kiu/RumbleRail/mech/readme.txt

Mechanical drawings (.fpd) are made with Frontplatten Designer
http://www.schaeffer-ag.de/de/download/frontplatten-designer.html
