kiu/RumbleRail/rrcmd/pcb/rrcmd.brd.png

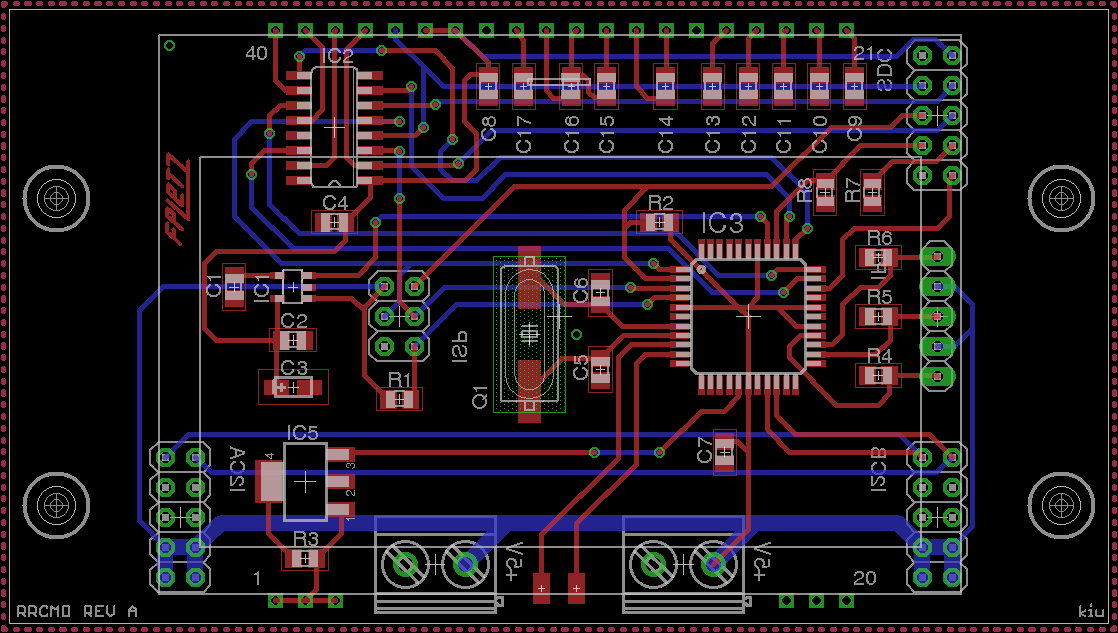
rrcmd/pcb/rrcmd.brd.png
