kiu/RumbleRail/rrcmd/pcb/rrcmd.sch.png

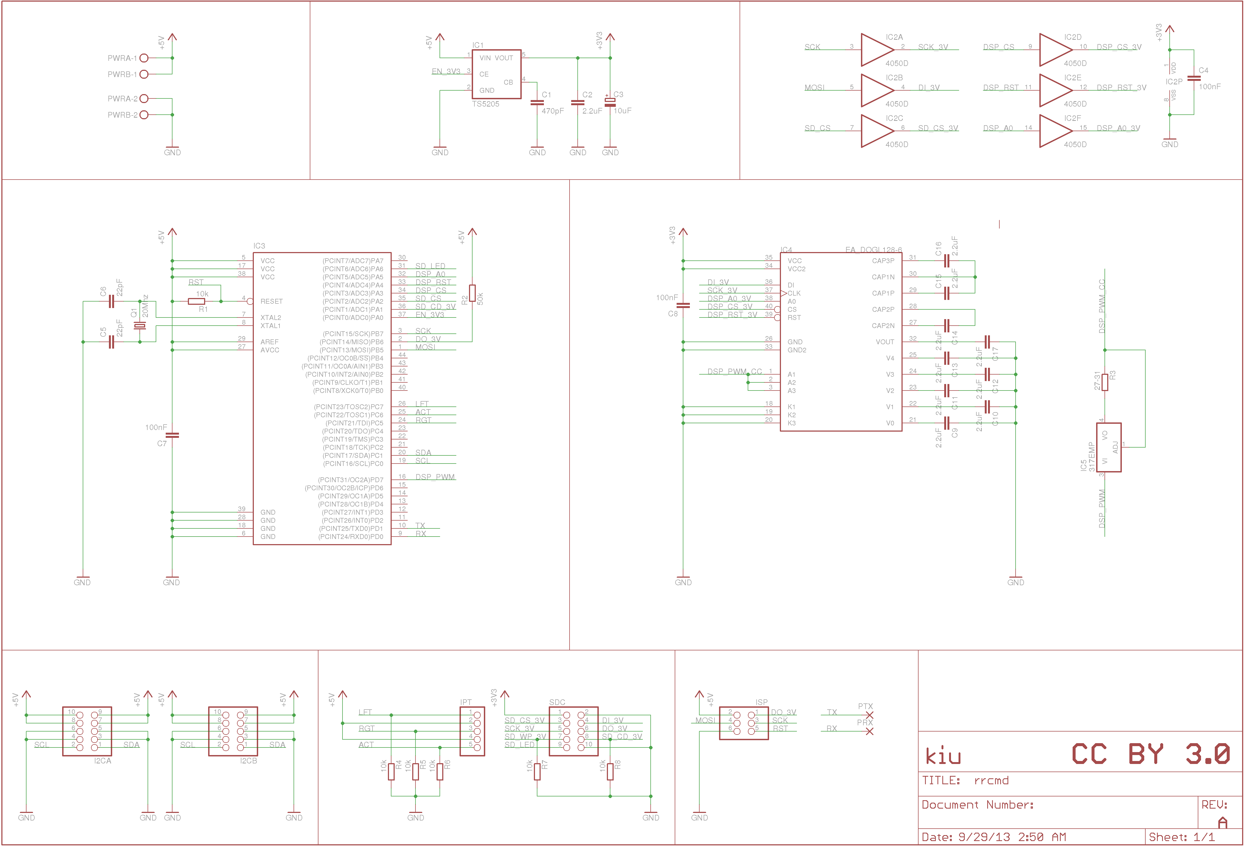
rrcmd/pcb/rrcmd.sch.png
