kiu/RumbleRail/rrfdc/pcb/rrfdc.brd.png

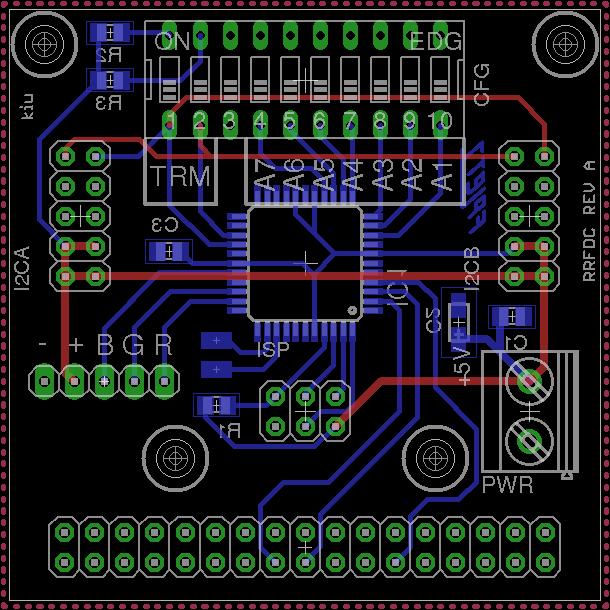
rrfdc/pcb/rrfdc.brd.png
