kiu/RumbleRail/rrfdc/pcb/rrfdc.sch.png

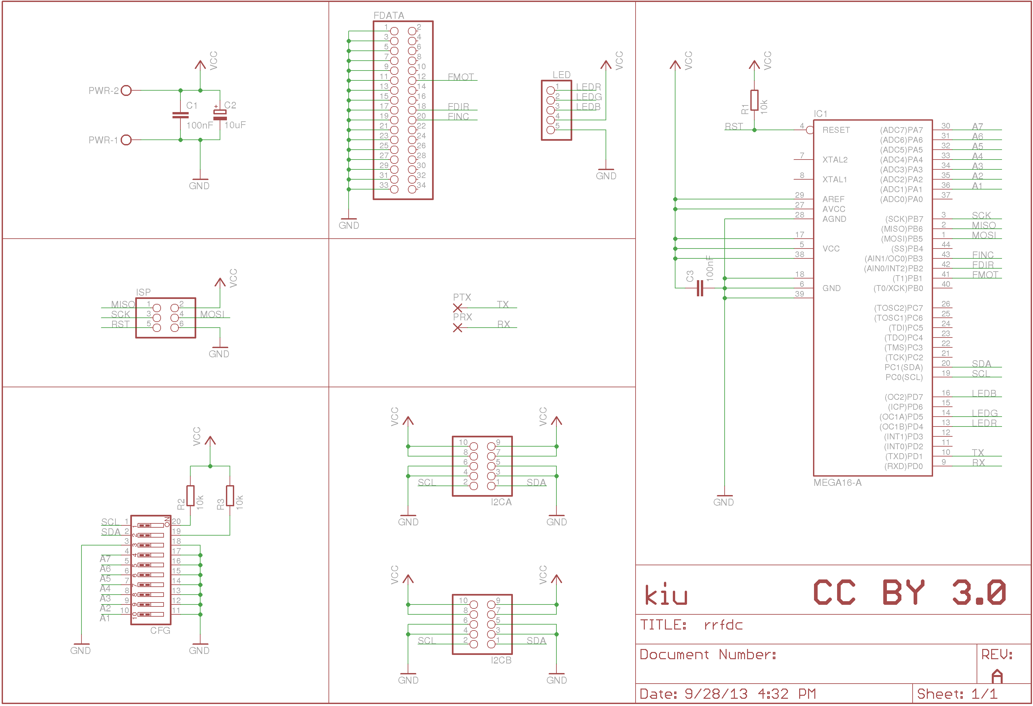
rrfdc/pcb/rrfdc.sch.png
