kiu/RumbleRail/rrled/pcb/rrled.brd.png

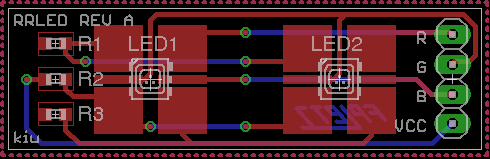
rrled/pcb/rrled.brd.png
