kiu/RumbleRail/rrled/pcb/rrled.sch.png

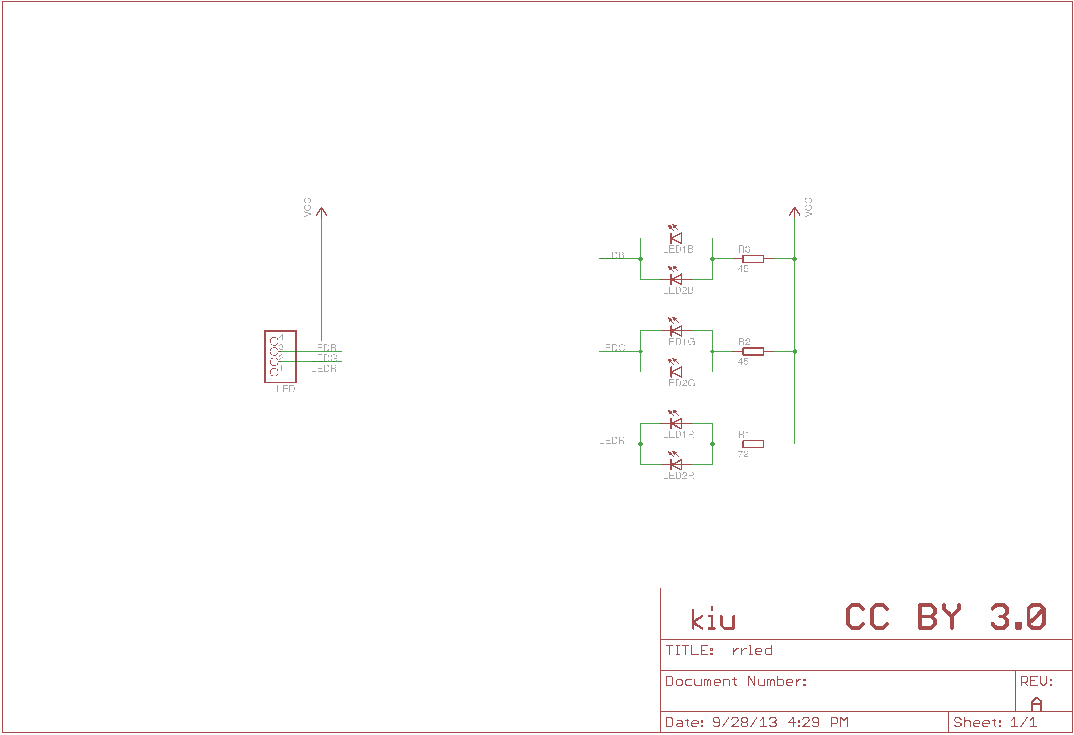
rrled/pcb/rrled.sch.png
