kiu/RumbleRail/rrsdc/pcb/rrsdc.brd.png

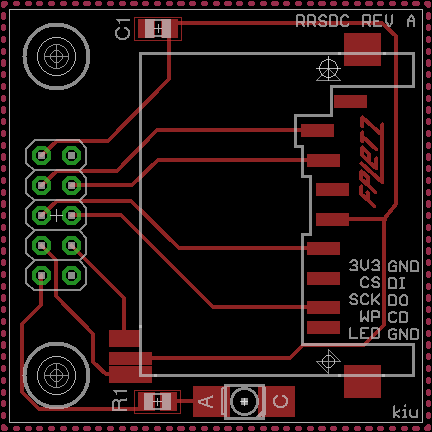
rrsdc/pcb/rrsdc.brd.png
