kiu/RumbleRail/rrsdc/pcb/rrsdc.sch.png

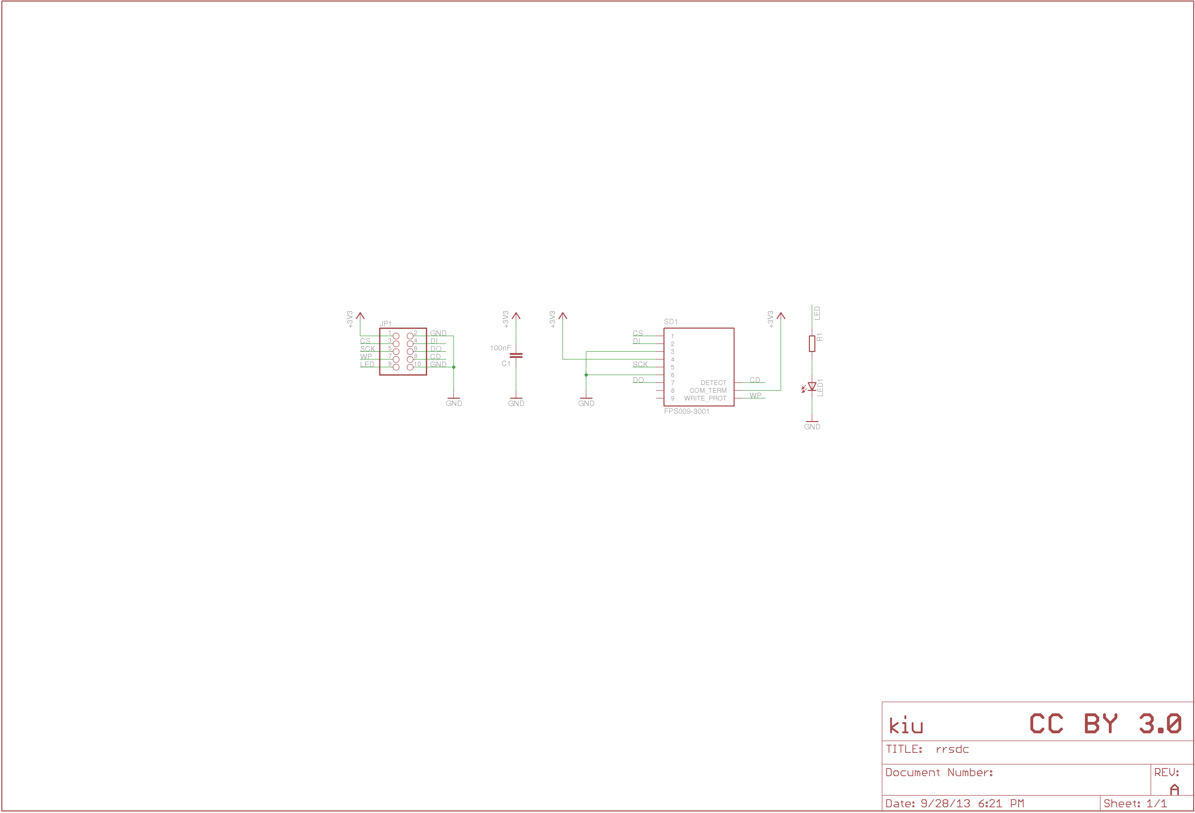
rrsdc/pcb/rrsdc.sch.png
