kiu/RumbleRail/bom.pdf

BOM

Ordered | Description | Qty | Price | Price (sum) | Id | Link

### 8x RRFDC

ATMEGA 16A-AU, TQFP-44 | 1 | 8 | 8 | 1.50 € | 12.00 € | ATMEGA 16A-AU
100nF 0805 | 2 | 8 | 100 | 0.01 € | 0.69 € | CC0805JRX7R9104
1 | 8 | 25 | 0.08 € | 1.99 € | TAJA106K006R
10k 0805 | 3 | 8 | 100 | 0.01 € | 0.83 € | SMD0805-10K-1%
DIP Switch 10 | 1 | 8 | 8 | 0.32 € | 2.56 € | NT 10
1 | 8 | 8 | 0.17 € | 1.36 € | WSL 34G
2 | 8 | 16 | 0.19 € | 3.04 € | PFL 34
1 | 1 | 1 | 3.20 € | 3.20 € | AWG 28-34G 3M
2 | 8 | 16 | 0.08 € | 1.28 € | WSL 10G
1 | 9 | 9 | 0.08 € | 0.72 € | PFL 10
1 | 1 | 1 | 3.00 € | 3.00 € | AWG 28-10F 3M
1 | 8 | 8 | 0.17 € | 1.36 € | WSL 6G
1 | 8 | 8 | 0.31 € | 2.48 € | AKL 101-02
1 | 8 | 8 | 0.57 € | 4.56 € | PS 25/5G BR
PCB 10x 50x50 Blue (RRFDC) | 0 | 0 | 0 | 0.00 € | 0.00 € | -
Screw M3x10 | 4 | 8 | 32 | 0.00 € | 0.00 € | -
4 | 8 | 32 | 0.04 € | 1.28 € | DK 5MM

### 8x RRLED

LED RGB | 2 | 8 | 16 | 0.99 € | 15.84 € | LRTB G6TG
45R (47) 0805 | 2 | 8 | 100 | 0.01 € | 0.83 € | SMD0805-47R-1%
72.5R (82) 0805 | 1 | 8 | 100 | 0.01 € | 0.83 € | SMD0805-82R-1%
PCB 10x 50x50 White (RRLED) | 0 | 0 | 0 | 0.00 € | 0.00 € | -

### 1x RRCMD

DOGL Display (128x64, Blue) | 1 | 1 | 1 | 21.10 € | 21.10 € | DOGL128B-6
1 | 1 | 1 | 16.85 € | 16.85 € | LED68X51-W
ATMEGA 1284P-AU | 1 | 1 | 1 | 5.90 € | 5.90 € | ATMEGA 1284P-AU
Crystal (20Mhz, HC49) | 1 | 1 | 1 | 0.24 € | 0.24 € | 20,0000-HC49-SMD
22pF | 2 | 1 | 2 | 0.05 € | 0.10 € | NPO-G0805 22P
LDO 3,3V 0.15A SOT235 | 1 | 1 | 1 | 0.29 € | 0.29 € | TS 5205 CX533
LM317 SOT-223 | 1 | 1 | 1 | 0.77 € | 0.77 € | LM 317 EMP
HC4050 | 1 | 1 | 1 | 0.26 € | 0.26 € | SMD HC 4050
470pF 0805 | 1 | 1 | 1 | 0.05 € | 0.05 € | NPO-G0805 470P
100nF 0805 | 3 | 1 | 100 | 0.01 € | 0.60 € | CC0805JRX7R9104
2.2uF 0805 | 10 | 1 | 100 | 0.02 € | 2.44 € | 0805YG225ZAT2A
1 | 1 | 25 | 0.08 € | 1.99 € | TAJA106K006R
10k 0805 | 6 | 1 | 100 | 0.01 € | 0.83 € | SMD0805-10K-1%
47k 0805 | 1 | 1 | 100 | 0.01 € | 0.83 € | SMD0805-47K-1%
33R (31.25) 0805 | 1 | 1 | 100 | 0.01 € | 0.83 € | SMD0805-33R-1%
1 | 1 | 1 | 0.57 € | 0.57 € | PS 25/5G BR
3 | 1 | 3 | 0.08 € | 0.24 € | WSL 10G
1 | 1 | 1 | 0.17 € | 0.17 € | WSL 6G
2 | 1 | 2 | 0.31 € | 0.62 € | AKL 101-02
1 | 1 | 1 | 3.95 € | 3.95 € | STEC11B09
Knopf | 1 | 1 | 1 | 3.30 € | 3.30 € | KNOPF 28-6 AL
1 | 1 | 1 | 0.22 € | 0.22 € | DECKEL 28M SW
PCB 5x 100x100 Red (RRCMD) | 0 | 0 | 0 | 0.00 € | 0.00 € | -
Screw M3x5 | 8 | 1 | 8 | 0.04 € | 0.29 € | B3X5/BN272

### 1x RRSDC

MMC/SD Holder | 1 | 1 | 1 | 0.81 € | 0.81 € | MCC-SD/1
100nF 0805 | 1 | 1 | 100 | 0.01 € | 0.60 € | CC0805JRX7R9104
1 | 1 | 1 | 0.08 € | 0.08 € | WSL 10G
2 | 1 | 2 | 0.08 € | 0.16 € | PFL 10
1 | 1 | 1 | 3.00 € | 3.00 € | AWG 28-10F 3M
PCB 5x 50x50 Red (RRSDC) | 0 | 0 | 0 | 0.00 € | 0.00 € | -
Screw M3x5 | 4 | 1 | 4 | 0.04 € | 0.14 € | B3X5/BN272
2 | 1 | 2 | 0.10 € | 0.20 € | TFF-M3X6/DR113

### Mechanical

Plate (Main) | 1 | 1 | 1 | 118.29 € | 118.29 € | -
Plate (Display) | 1 | 1 | 1 | 65.37 € | 65.37 € | -
Plate (Holder) | 1 | 1 | 1 | 31.40 € | 31.40 € | -
Shipping | 1 | 1 | 1 | 4.95 € | 4.95 € | -

### Misc

Power supply (5V, 8A) | 1 | 1 | 1 | 18.10 € | 18.10 € | SNT MW40-05
Power cord | 1 | 1 | 1 | 1.40 € | 1.40 € | NKS 200 SW
Power cable | 1 | 1 | 1 | 1.40 € | 1.40 € | LAT 275-5
SD Card 4GB | 1 | 1 | 1 | 3.80 € | 3.80 € | SAMSUNG MB-SS4GA
Floppy drives | 1 | 8 | 1 | 26.00 € | 26.00 € | -
0.5 | 8 | 4 | 1.59 € | 6.36 € | -
Shipping | 1 | 1 | 1 | 2.60 € | 2.60 € | -
Screw M3x5 | 8 | 8 | 64 | 0.04 € | 2.30 € | B3X5/BN272
4 | 8 | 32 | 0.10 € | 3.26 € | TFF-M3X6/DR113
Hex Bolt M5x50 | 4 | 1 | 4 | 0.00 € | 0.00 € | -
1 | 1 | 1 | 130.00 € | 130.00 € | (price may be incorrect!)
Shipping | 1 | 1 | 1 | 5.60 € | 5.60 € | -
Shipping | 1 | 1 | 1 | 5.90 € | 5.90 € | -

### SUM

552.03 € | (for 8 drives)
Req | Mul

http://www.reichelt.de
http://www.tme.eu
Tantal 10uF A | http://www.tme.eu
| http://www.tme.eu
| http://www.reichelt.de
Wannenstecker, 34-polig, gerade | http://www.reichelt.de
Pfostenbuchse (34pin) | http://www.reichelt.de
Ribboncable (34pin, 3m) | http://www.reichelt.de
Wannenstecker, 10-polig, gerade | http://www.reichelt.de
Pfostenbuchse (10pin) | http://www.reichelt.de
Ribboncable (10pin, 3m) | http://www.reichelt.de
Wannenstecker, 6-polig, gerade | http://www.reichelt.de
Anreihklemme 2pin, 5.08mm | http://www.reichelt.de
Platinensteckverbinder (5pin) | http://www.reichelt.de
| http://www.seeedstudio.com
Abstandshuelse M3x5 | http://www.reichelt.de

http://www.reichelt.de
http://www.tme.eu
http://www.tme.eu
http://www.seeedstudio.com

http://www.reichelt.de
DOGL Backlight (White) | http://www.reichelt.de
| http://www.reichelt.de
| http://www.reichelt.de
| http://www.reichelt.de
| http://www.reichelt.de
| http://www.reichelt.de
| http://www.reichelt.de
| http://www.reichelt.de
| http://www.tme.eu
| http://www.tme.eu
Tantal 10uF A | http://www.tme.eu
| http://www.tme.eu
| http://www.tme.eu
| http://www.tme.eu
Platinensteckverbinder (5pin) | http://www.reichelt.de
Wannenstecker, 10-polig, gerade | http://www.reichelt.de
Wannenstecker, 6-polig, gerade | http://www.reichelt.de
Anreihklemme 2pin, 5.08mm | http://www.reichelt.de
Drehimpulsgeber | http://www.reichelt.de
| http://www.reichelt.de
Deckel | http://www.reichelt.de
| http://www.seeedstudio.com
| http://www.tme.eu

http://www.tme.eu
http://www.tme.eu
Wannenstecker, 10-polig, gerade | http://www.reichelt.de
Pfostenbuchse (10pin) | http://www.reichelt.de
Ribboncable (10pin, 3m) | http://www.reichelt.de
| http://www.seeedstudio.com
| http://www.tme.eu
Abstandshuelse M3x6 | http://www.tme.eu

http://www.schaeffer-ag.dehttp://www.schaeffer-ag.dehttp://www.schaeffer-ag.dehttp://www.schaeffer-ag.de

http://www.reichelt.de
http://www.reichelt.de
http://www.reichelt.de

http://www.reichelt.de

http://www.ebay.de
Floppy Y Stromkabel | http://www.ebay.de
| http://www.ebay.de
| http://www.tme.eu
Abstandshuelse M3x6 | http://www.tme.eu
PCBs manufacturing, shipping, tax | http://www.seeedstudio.com
| http://www.reichelt.de http://www.tme.eu
A | B | C | D | E | F | G | H | I
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
