kiu/RumbleRail/bom.ods

Ordered | Description | Req | Mul | Qty | Price | Price (sum) | Id | Link
 | 8x RRFDC
 | ATMEGA 16A-AU, TQFP-44 | 1 | 8 | 8 | 1.50 € | 12.00 € | ATMEGA 16A-AU | http://www.reichelt.de
 | 100nF 0805 | 2 | 8 | 100 | 0.01 € | 0.69 € | CC0805JRX7R9104 | http://www.tme.eu
 | Tantal 10uF A | 1 | 8 | 25 | 0.08 € | 1.99 € | TAJA106K006R | http://www.tme.eu
 | 10k 0805 | 3 | 8 | 100 | 0.01 € | 0.83 € | SMD0805-10K-1% | http://www.tme.eu
 | DIP Switch 10 | 1 | 8 | 8 | 0.32 € | 2.56 € | NT 10 | http://www.reichelt.de
 | Wannenstecker, 34-polig, gerade | 1 | 8 | 8 | 0.17 € | 1.36 € | WSL 34G | http://www.reichelt.de
 | Pfostenbuchse (34pin) | 2 | 8 | 16 | 0.19 € | 3.04 € | PFL 34 | http://www.reichelt.de
 | Ribboncable (34pin, 3m) | 1 | 1 | 1 | 3.20 € | 3.20 € | AWG 28-34G 3M | http://www.reichelt.de
 | Wannenstecker, 10-polig, gerade | 2 | 8 | 16 | 0.08 € | 1.28 € | WSL 10G | http://www.reichelt.de
 | Pfostenbuchse (10pin) | 1 | 9 | 9 | 0.08 € | 0.72 € | PFL 10 | http://www.reichelt.de
 | Ribboncable (10pin, 3m) | 1 | 1 | 1 | 3.00 € | 3.00 € | AWG 28-10F 3M | http://www.reichelt.de
 | Wannenstecker, 6-polig, gerade | 1 | 8 | 8 | 0.17 € | 1.36 € | WSL 6G | http://www.reichelt.de
 | Anreihklemme 2pin, 5.08mm | 1 | 8 | 8 | 0.31 € | 2.48 € | AKL 101-02 | http://www.reichelt.de
 | Platinensteckverbinder (5pin) | 1 | 8 | 8 | 0.57 € | 4.56 € | PS 25/5G BR | http://www.reichelt.de
 | PCB 10x 50x50 Blue (RRFDC) | 0 | 0 | 0 | 0.00 € | 0.00 € | - | http://www.seeedstudio.com
 | Screw M3x10 | 4 | 8 | 32 | 0.00 € | 0.00 € | -
 | Abstandshuelse M3x5 | 4 | 8 | 32 | 0.04 € | 1.28 € | DK 5MM | http://www.reichelt.de
 | 8x RRLED
 | LED RGB | 2 | 8 | 16 | 0.99 € | 15.84 € | LRTB G6TG | http://www.reichelt.de
 | 45R (47) 0805 | 2 | 8 | 100 | 0.01 € | 0.83 € | SMD0805-47R-1% | http://www.tme.eu
 | 72.5R (82) 0805 | 1 | 8 | 100 | 0.01 € | 0.83 € | SMD0805-82R-1% | http://www.tme.eu
 | PCB 10x 50x50 White (RRLED) | 0 | 0 | 0 | 0.00 € | 0.00 € | - | http://www.seeedstudio.com
 | 1x RRCMD
 | DOGL Display (128x64, Blue) | 1 | 1 | 1 | 21.10 € | 21.10 € | DOGL128B-6 | http://www.reichelt.de
 | DOGL Backlight (White) | 1 | 1 | 1 | 16.85 € | 16.85 € | LED68X51-W | http://www.reichelt.de
 | ATMEGA 1284P-AU | 1 | 1 | 1 | 5.90 € | 5.90 € | ATMEGA 1284P-AU | http://www.reichelt.de
 | Crystal (20Mhz, HC49) | 1 | 1 | 1 | 0.24 € | 0.24 € | 20,0000-HC49-SMD | http://www.reichelt.de
 | 22pF | 2 | 1 | 2 | 0.05 € | 0.10 € | NPO-G0805 22P | http://www.reichelt.de
 | LDO 3,3V 0.15A SOT235 | 1 | 1 | 1 | 0.29 € | 0.29 € | TS 5205 CX533 | http://www.reichelt.de
 | LM317 SOT-223 | 1 | 1 | 1 | 0.77 € | 0.77 € | LM 317 EMP | http://www.reichelt.de
 | HC4050 | 1 | 1 | 1 | 0.26 € | 0.26 € | SMD HC 4050 | http://www.reichelt.de
 | 470pF 0805 | 1 | 1 | 1 | 0.05 € | 0.05 € | NPO-G0805 470P | http://www.reichelt.de
 | 100nF 0805 | 3 | 1 | 100 | 0.01 € | 0.60 € | CC0805JRX7R9104 | http://www.tme.eu
 | 2.2uF 0805 | 10 | 1 | 100 | 0.02 € | 2.44 € | 0805YG225ZAT2A | http://www.tme.eu
 | Tantal 10uF A | 1 | 1 | 25 | 0.08 € | 1.99 € | TAJA106K006R | http://www.tme.eu
 | 10k 0805 | 6 | 1 | 100 | 0.01 € | 0.83 € | SMD0805-10K-1% | http://www.tme.eu
 | 47k 0805 | 1 | 1 | 100 | 0.01 € | 0.83 € | SMD0805-47K-1% | http://www.tme.eu
 | 33R (31.25) 0805 | 1 | 1 | 100 | 0.01 € | 0.83 € | SMD0805-33R-1% | http://www.tme.eu
 | Platinensteckverbinder (5pin) | 1 | 1 | 1 | 0.57 € | 0.57 € | PS 25/5G BR | http://www.reichelt.de
 | Wannenstecker, 10-polig, gerade | 3 | 1 | 3 | 0.08 € | 0.24 € | WSL 10G | http://www.reichelt.de
 | Wannenstecker, 6-polig, gerade | 1 | 1 | 1 | 0.17 € | 0.17 € | WSL 6G | http://www.reichelt.de
 | Anreihklemme 2pin, 5.08mm | 2 | 1 | 2 | 0.31 € | 0.62 € | AKL 101-02 | http://www.reichelt.de
 | Drehimpulsgeber | 1 | 1 | 1 | 3.95 € | 3.95 € | STEC11B09 | http://www.reichelt.de
 | Knopf | 1 | 1 | 1 | 3.30 € | 3.30 € | KNOPF 28-6 AL | http://www.reichelt.de
 | Deckel | 1 | 1 | 1 | 0.22 € | 0.22 € | DECKEL 28M SW | http://www.reichelt.de
 | PCB 5x 100x100 Red (RRCMD) | 0 | 0 | 0 | 0.00 € | 0.00 € | - | http://www.seeedstudio.com
 | Screw M3x5 | 8 | 1 | 8 | 0.04 € | 0.29 € | B3X5/BN272 | http://www.tme.eu
 | 1x RRSDC
 | MMC/SD Holder | 1 | 1 | 1 | 0.81 € | 0.81 € | MCC-SD/1 | http://www.tme.eu
 | 100nF 0805 | 1 | 1 | 100 | 0.01 € | 0.60 € | CC0805JRX7R9104 | http://www.tme.eu
 | Wannenstecker, 10-polig, gerade | 1 | 1 | 1 | 0.08 € | 0.08 € | WSL 10G | http://www.reichelt.de
 | Pfostenbuchse (10pin) | 2 | 1 | 2 | 0.08 € | 0.16 € | PFL 10 | http://www.reichelt.de
 | Ribboncable (10pin, 3m) | 1 | 1 | 1 | 3.00 € | 3.00 € | AWG 28-10F 3M | http://www.reichelt.de
 | PCB 5x 50x50 Red (RRSDC) | 0 | 0 | 0 | 0.00 € | 0.00 € | - | http://www.seeedstudio.com
 | Screw M3x5 | 4 | 1 | 4 | 0.04 € | 0.14 € | B3X5/BN272 | http://www.tme.eu
 | Abstandshuelse M3x6 | 2 | 1 | 2 | 0.10 € | 0.20 € | TFF-M3X6/DR113 | http://www.tme.eu
 | Mechanical
 | Plate (Rail) | 1 | 1 | 1 | 118.29 € | 118.29 € | - | http://www.schaeffer-ag.de
 | Plate (Display) | 1 | 1 | 1 | 65.37 € | 65.37 € | - | http://www.schaeffer-ag.de
 | Plate (Mount) | 1 | 1 | 1 | 31.40 € | 31.40 € | - | http://www.schaeffer-ag.de
 | Shipping | 1 | 1 | 1 | 4.95 € | 4.95 € | - | http://www.schaeffer-ag.de
 | Misc
 | Power supply (5V, 8A) | 1 | 1 | 1 | 18.10 € | 18.10 € | SNT MW40-05 | http://www.reichelt.de
 | Power cord | 1 | 1 | 1 | 1.40 € | 1.40 € | NKS 200 SW | http://www.reichelt.de
 | Power cable | 1 | 1 | 1 | 1.40 € | 1.40 € | LAT 275-5 | http://www.reichelt.de
 | SD Card 4GB | 1 | 1 | 1 | 3.80 € | 3.80 € | SAMSUNG MB-SS4GA | http://www.reichelt.de
 | Floppy drives | 1 | 8 | 1 | 26.00 € | 26.00 € | - | http://www.ebay.de
 | Floppy Y Stromkabel | 0.5 | 8 | 4 | 1.59 € | 6.36 € | - | http://www.ebay.de
 | Shipping | 1 | 1 | 1 | 2.60 € | 2.60 € | - | http://www.ebay.de
 | Screw M3x5 | 8 | 8 | 64 | 0.04 € | 2.30 € | B3X5/BN272 | http://www.tme.eu
 | Abstandshuelse M3x6 | 4 | 8 | 32 | 0.10 € | 3.26 € | TFF-M3X6/DR113 | http://www.tme.eu
 | Hex Bolt M5x50 | 4 | 1 | 4 | 0.00 € | 0.00 € | -
 | PCBs manufacturing, shipping, tax | 1 | 1 | 1 | 130.00 € | 130.00 € | (price may be incorrect!) | http://www.seeedstudio.com
 | Shipping | 1 | 1 | 1 | 5.60 € | 5.60 € | - | http://www.reichelt.de
 | Shipping | 1 | 1 | 1 | 5.90 € | 5.90 € | - | http://www.tme.eu
 |  |  |  |  |  | SUM
 |  |  |  |  |  | 552.03 € | (for 8 drives)
