kiu/RumbleRail/mech/rr_rail.dxf

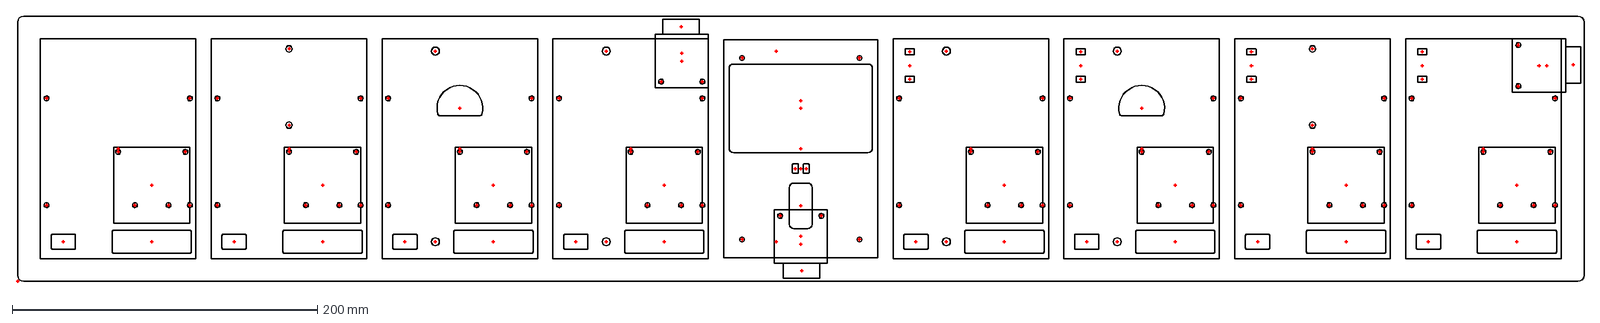
[picture p9: CAD file, 2014-01-03]
mech/rr_rail.dxf
1028.0 x 175.0 mm
