kiu/RumbleRail/mech/rr_rail_manu.dxf

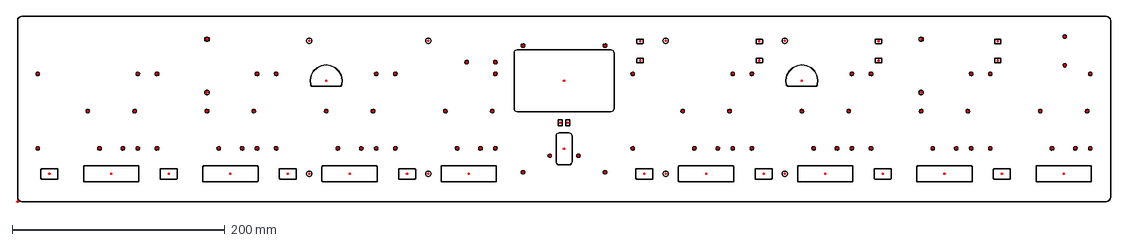
[picture p10: CAD file, 2014-01-03]
mech/rr_rail_manu.dxf
1028.0 x 175.0 mm
