kiu/RumbleRail/mech/rr_mount.dxf

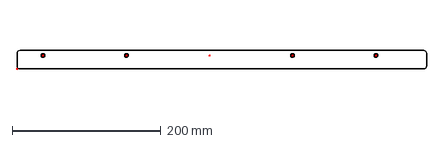
[picture p11: CAD file, 2014-01-03]
mech/rr_mount.dxf
551.0 x 26.0 mm
