kiu/RumbleRail/mech/rr_display.dxf

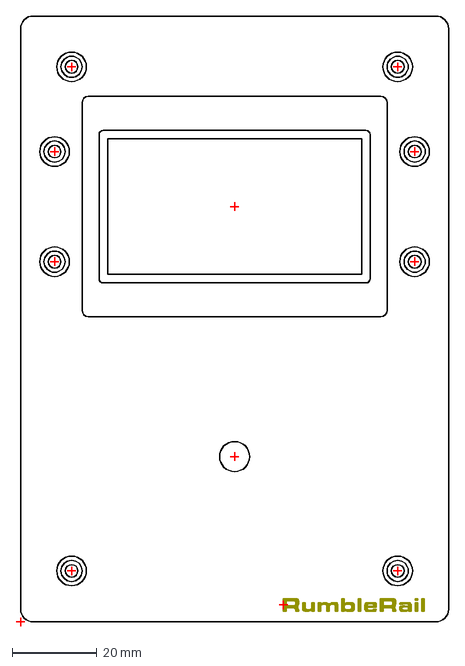
[picture p12: CAD file, 2014-01-03]
mech/rr_display.dxf
102.0 x 144.0 mm
