kiu/RumbleRail/mech/rr_display.pdf

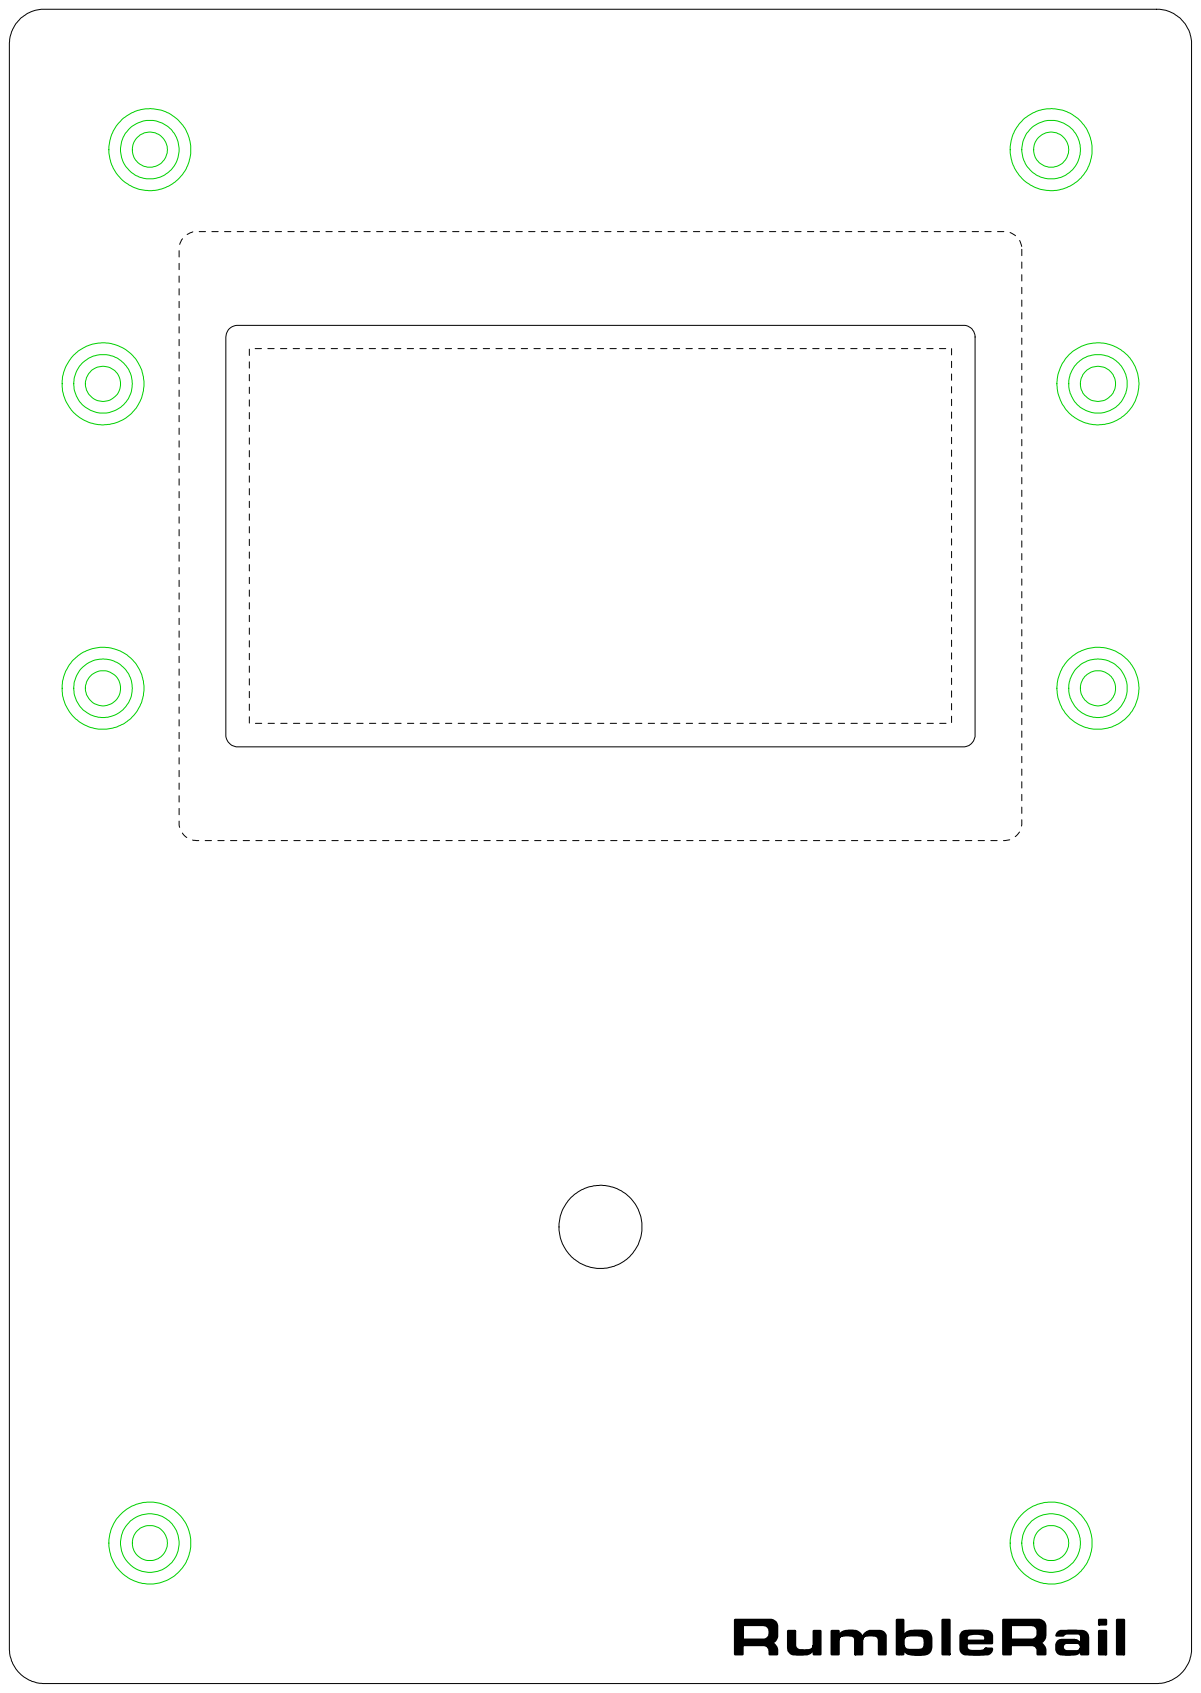
[picture p13: page 1]
