kiu/RumbleRail/mech/rr_rail.pdf

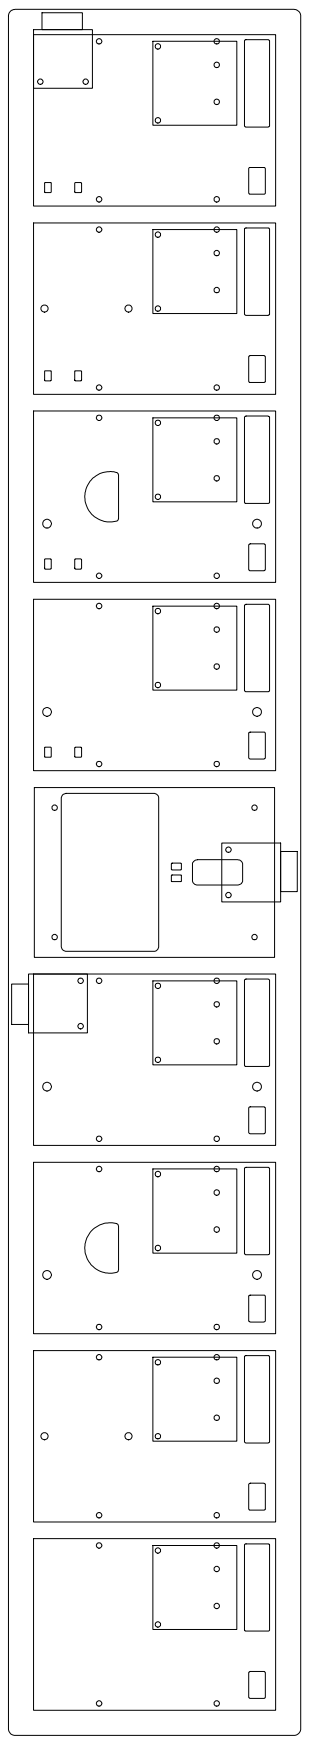
[picture p14: page 1]
