kiu/RumbleRail/mech/rr_rail_manu.pdf

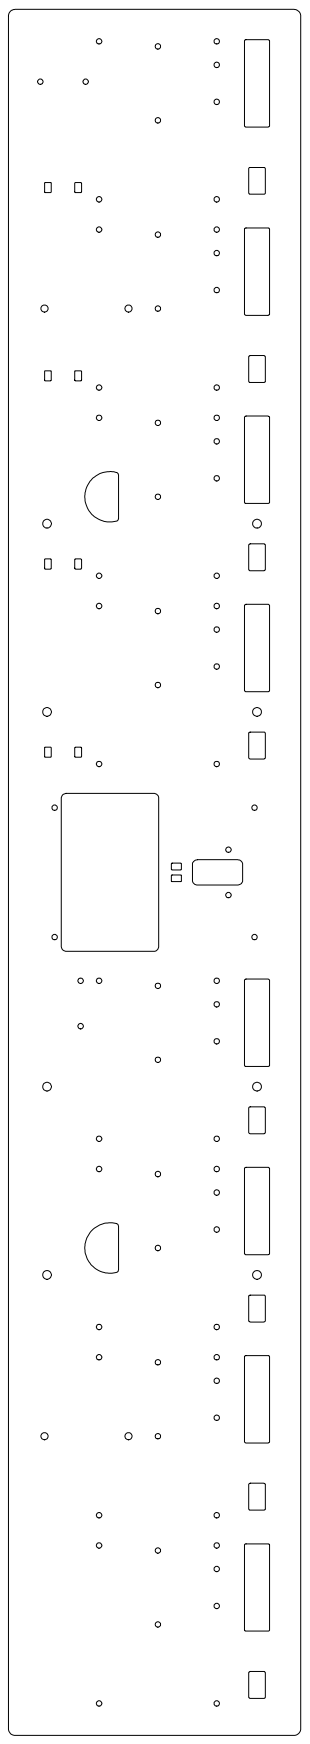
[picture p15: page 1]
