kiu/RumbleRail/rrcmd/pcb/rrcmd.brd

## EAGLE design rrcmd/pcb/rrcmd.brd (2014-01-03)

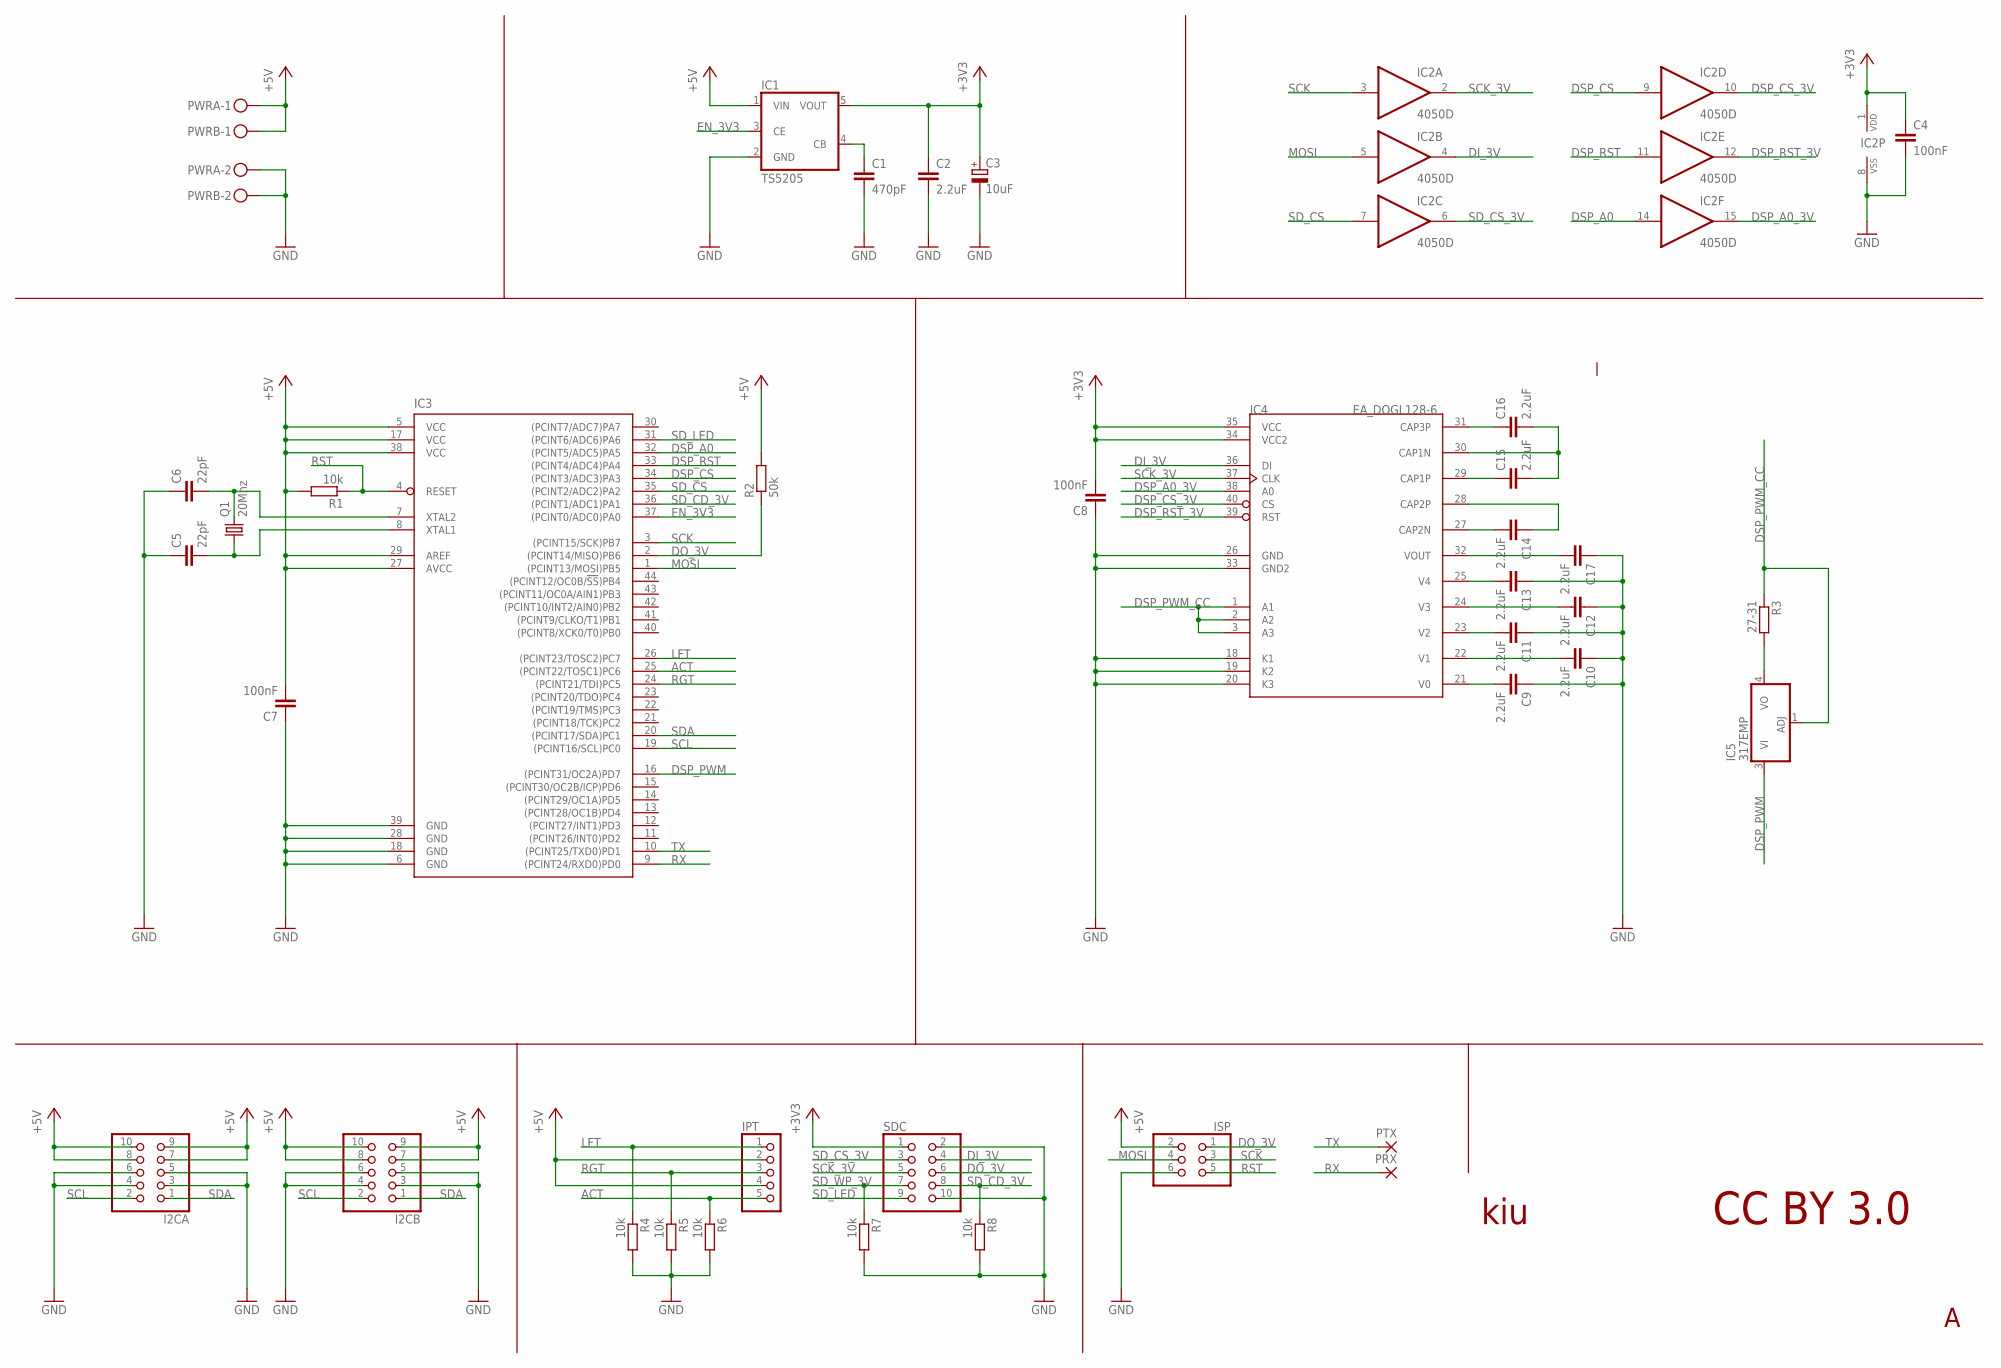
[picture p16: schematic rrcmd.sch]

Parts:
C1: 470pF; C0805
C2, C9, C10, C11, C12, C13, C14, C15, C16, C17: 2.2uF; C0805
C3: 10uF; CT3216
C4, C7, C8: 100nF; C0805
C5, C6: 22pF; C0805
I2CA, I2CB: PINHD-2X5; 2X05
IC1: TS5205; SOT25
IC2: 4050D; SO16
IC3: ATMEGA644A; TQFP44
IC4: EA_DOGL128-6
IC5: 317EMP; SOT223
IPT: PINHD-1X5; 1X05
ISP: PINHD-2X3; 2X03
PRX: SMD2; SMD1,27-2,54
PTX: SMD2; SMD1,27-2,54
PWRA: MKDSN1,5/2-5,08
PWRB: MKDSN1,5/2-5,08
Q1: 20Mhz; HC49UP
R1, R4, R5, R6, R7, R8: 10k; R0805
R2: 50k; R0805
R3: 27-31; R0805
SDC: PINHD-2X5; 2X05

Connections:
+3V3: C2.1, C3.+, C4.1, C8.2, IC1.5 (VOUT), IC2.1 (VDD), IC4.34 (VCC2), IC4.35 (VCC), SDC.1
+5V: C7.2, I2CA.7, I2CA.8, I2CA.9, I2CA.10, I2CB.7, I2CB.8, I2CB.9, I2CB.10, IC1.1 (VIN), IC3.5 (VCC), IC3.17 (VCC), IC3.27 (AVCC), IC3.29 (AREF), IC3.38 (VCC), IPT.2, IPT.4, ISP.2, PWRA.1, PWRB.1, R1.2, R2.2
ACT: IC3.25 ((PCINT22/TOSC1)PC6), IPT.5, R6.1
CAP1N: C15.2, C16.2, IC4.30 (CAP1N)
CAP1P: C15.1, IC4.29 (CAP1P)
CAP2N: C14.2, IC4.27 (CAP2N)
CAP2P: C14.1, IC4.28 (CAP2P)
CAP3P: C16.1, IC4.31 (CAP3P)
DI_3V: IC2.4 (O), IC4.36 (DI), SDC.4
DO_3V: IC3.2 ((PCINT14/MISO)PB6), ISP.1, R2.1, SDC.6
DSP_A0: IC2.14 (I), IC3.32 ((PCINT5/ADC5)PA5)
DSP_A0_3V: IC2.15 (O), IC4.38 (A0)
DSP_CS: IC2.9 (I), IC3.34 ((PCINT3/ADC3)PA3)
DSP_CS_3V: IC2.10 (O), IC4.40 (CS)
DSP_PWM: IC3.16 ((PCINT31/OC2A)PD7), IC5.3 (VI)
DSP_PWM_CC: IC4.1 (A1), IC4.2 (A2), IC4.3 (A3), IC5.1 (ADJ), R3.1
DSP_RST: IC2.11 (I), IC3.33 ((PCINT4/ADC4)PA4)
DSP_RST_3V: IC2.12 (O), IC4.39 (RST)
EN_3V3: IC1.3 (CE), IC3.37 ((PCINT0/ADC0)PA0)
GND: C1.2, C2.2, C3.-, C4.2, C5.1, C6.1, C7.1, C8.1, C9.1, C10.1, C11.1, C12.1, C13.1, C17.1, I2CA.3, I2CA.4, I2CA.5, I2CA.6, I2CB.3, I2CB.4, I2CB.5, I2CB.6, IC1.2 (GND), IC2.8 (VSS), IC3.6 (GND), IC3.18 (GND), IC3.28 (GND), IC3.39 (GND), IC4.18 (K1), IC4.19 (K2), IC4.20 (K3), IC4.26 (GND), IC4.33 (GND2), ISP.6, PWRA.2, PWRB.2, R4.2, R5.2, R6.2, R7.2, R8.2, SDC.2, SDC.10
LFT: IC3.26 ((PCINT23/TOSC2)PC7), IPT.1, R4.1
MOSI: IC2.5 (I), IC3.1 ((PCINT13/MOSI)PB5), ISP.4
unnamed: C1.1, IC1.4 (CB)
unnamed: C12.2, IC4.24 (V3)
unnamed: C13.2, IC4.25 (V4)
unnamed: C11.2, IC4.23 (V2)
unnamed: C10.2, IC4.22 (V1)
unnamed: C9.2, IC4.21 (V0)
unnamed: C17.2, IC4.32 (VOUT)
unnamed: IC5.4 (VO), R3.2
unnamed: C6.2, IC3.7 (XTAL2), Q1.2
unnamed: C5.2, IC3.8 (XTAL1), Q1.1
RGT: IC3.24 ((PCINT21/TDI)PC5), IPT.3, R5.1
RST: IC3.4 (RESET), ISP.5, R1.1
RX: IC3.9 ((PCINT24/RXD0)PD0), PRX.1
SCK: IC2.3 (I), IC3.3 ((PCINT15/SCK)PB7), ISP.3
SCK_3V: IC2.2 (O), IC4.37 (CLK), SDC.5
SCL: I2CA.2, I2CB.2, IC3.19 ((PCINT16/SCL)PC0)
SDA: I2CA.1, I2CB.1, IC3.20 ((PCINT17/SDA)PC1)
SD_CD_3V: IC3.36 ((PCINT1/ADC1)PA1), R8.1, SDC.8
SD_CS: IC2.7 (I), IC3.35 ((PCINT2/ADC2)PA2)
SD_CS_3V: IC2.6 (O), SDC.3
SD_LED: IC3.31 ((PCINT6/ADC6)PA6), SDC.9
SD_WP_3V: R7.1, SDC.7
TX: IC3.10 ((PCINT25/TXD0)PD1), PTX.1

Notes on the sheet:
CC BY 3.0
kiu

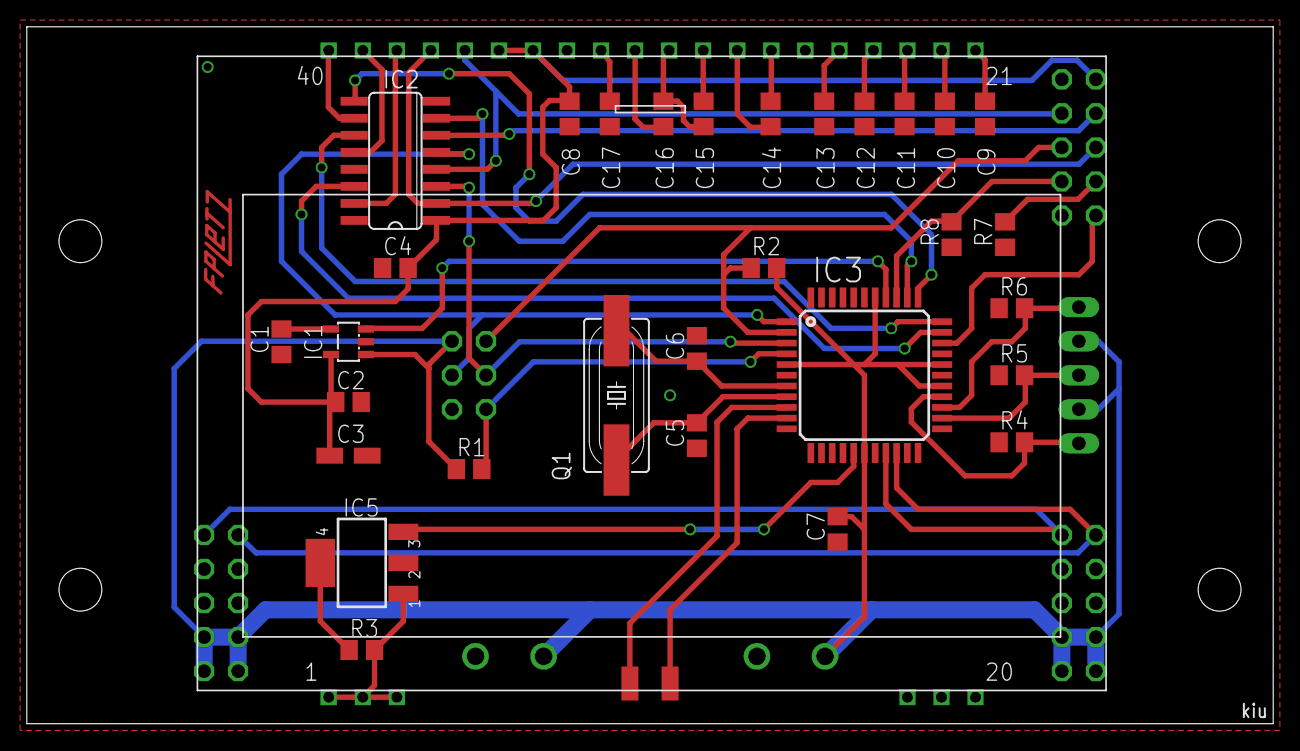
[picture p17: board rrcmd.brd from above]

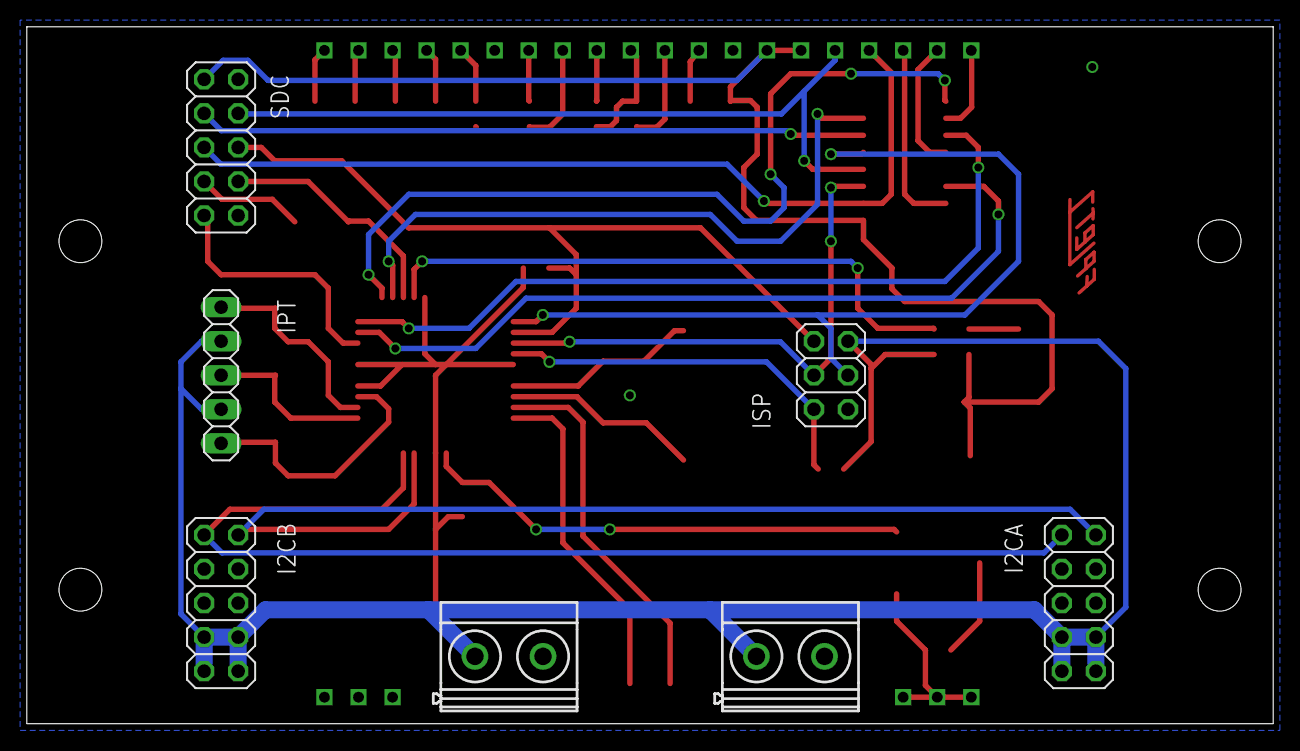
[picture p18: board rrcmd.brd from below]

Board: 4 copper layers, 93.0 x 52.0 mm, 40 parts (7 on the bottom side), 45 nets.
