kiu/RumbleRail/rrled/pcb/rrled.brd

## EAGLE design rrled/pcb/rrled.brd (2014-01-03)

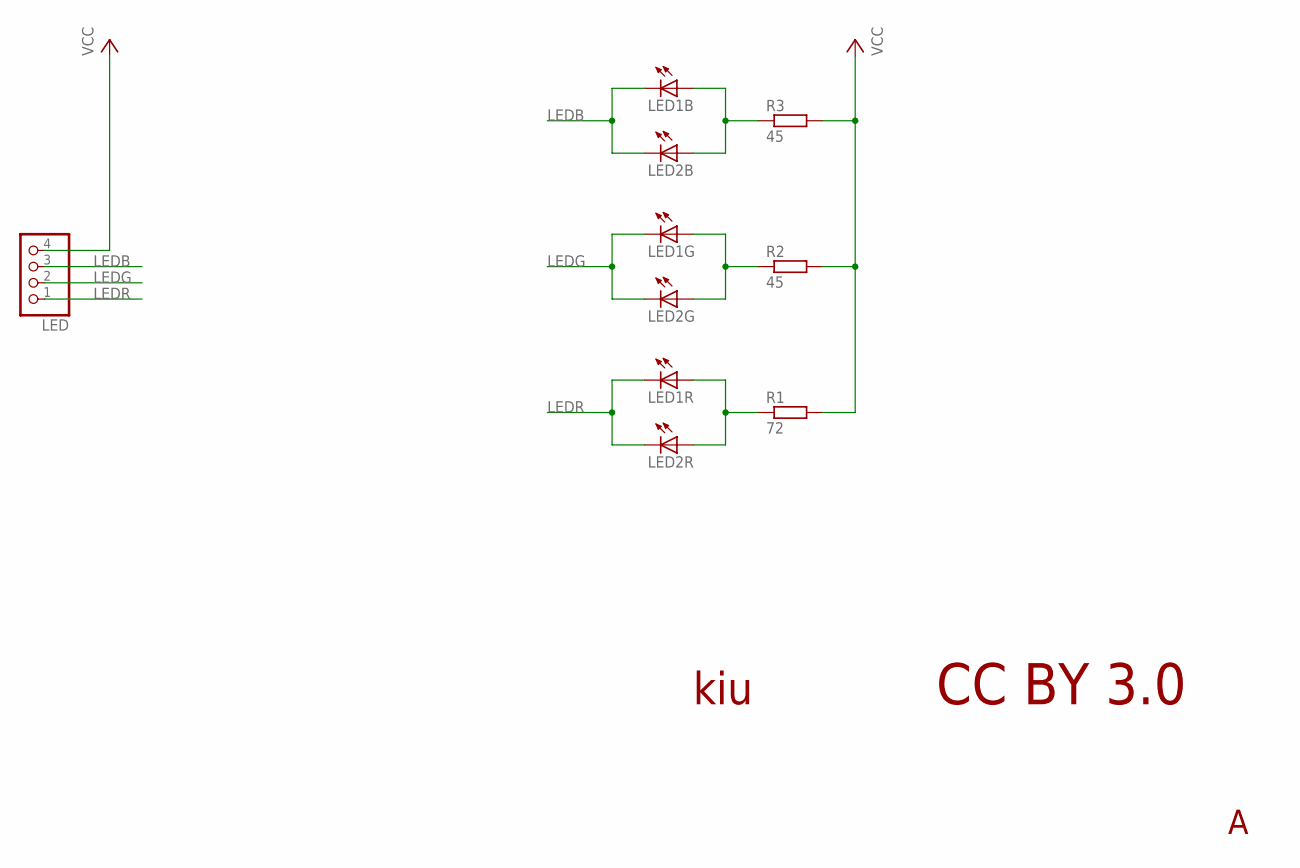
[picture p19: schematic rrled.sch]

Parts:
LED: PINHD-1X4; 1X04
LED1, LED2: MULTILED_LRTB_G6TG; P-LCC-6_TOPLED
R1: 72; R0603
R2, R3: 45; R0603

Connections:
LEDB: LED.3, LED1.C3 (C), LED2.C3 (C)
LEDG: LED.2, LED1.C2 (C), LED2.C2 (C)
LEDR: LED.1, LED1.C1 (C), LED2.C1 (C)
unnamed: LED1.A2 (A), LED2.A2 (A), R2.1
unnamed: LED1.A3 (A), LED2.A3 (A), R3.1
unnamed: LED1.A1 (A), LED2.A1 (A), R1.1
VCC: LED.4, R1.2, R2.2, R3.2

Notes on the sheet:
CC BY 3.0
kiu

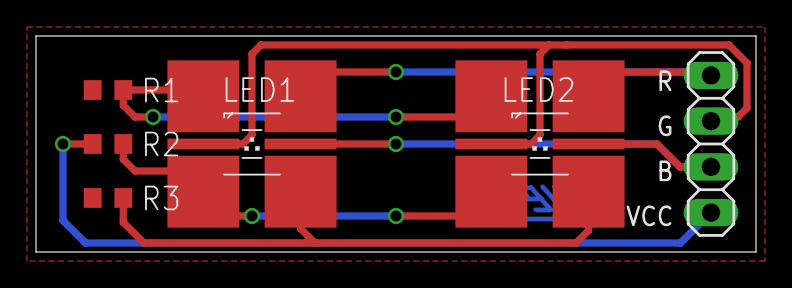
[picture p20: board rrled.brd from above]

Board: 4 copper layers, 40.0 x 12.0 mm, 6 parts (0 on the bottom side), 7 nets.
