kiu/RumbleRail/rrsdc/pcb/rrsdc.brd

## EAGLE design rrsdc/pcb/rrsdc.brd (2014-01-03)

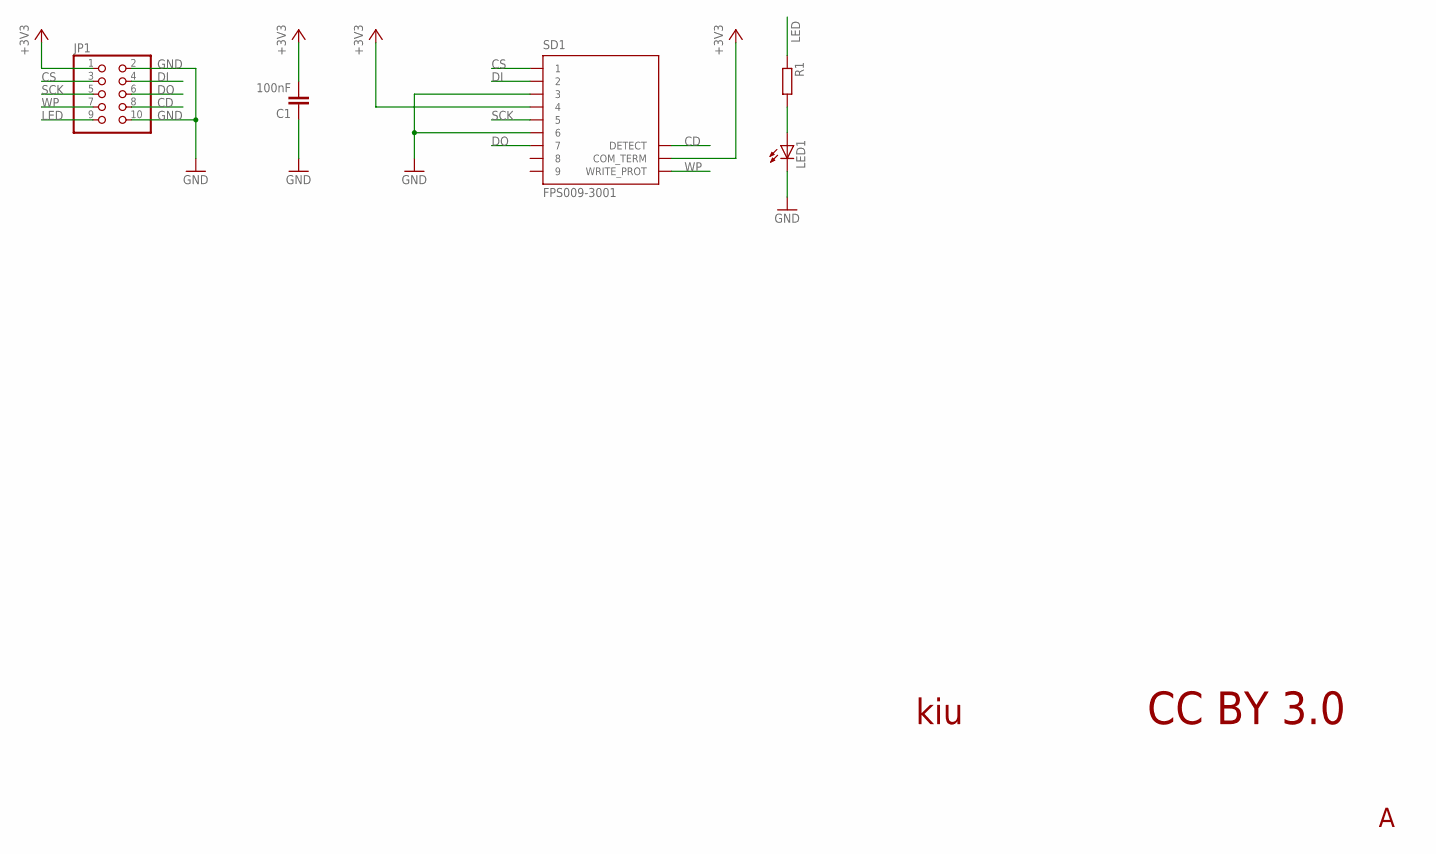
[picture p21: schematic rrsdc.sch]

Parts:
C1: 100nF; C0805
JP1: PINHD-2X5; 2X05
LED1: SIDELEDPLCC-NOTHERM; PLCC-2-NOTHERM
R1: R-EU_R0805; R0805
SD1: FPS009-3001; FPS009-3000

Connections:
+3V3: C1.2, JP1.1, SD1.4, SD1.COM_TERM
CD: JP1.8, SD1.DETECT
CS: JP1.3, SD1.1
DI: JP1.4, SD1.2
DO: JP1.6, SD1.7
GND: C1.1, JP1.2, JP1.10, LED1.C, SD1.3, SD1.6
LED: JP1.9, R1.1
unnamed: LED1.A, R1.2
SCK: JP1.5, SD1.5
WP: JP1.7, SD1.WRITE_PROT

Notes on the sheet:
CC BY 3.0
kiu

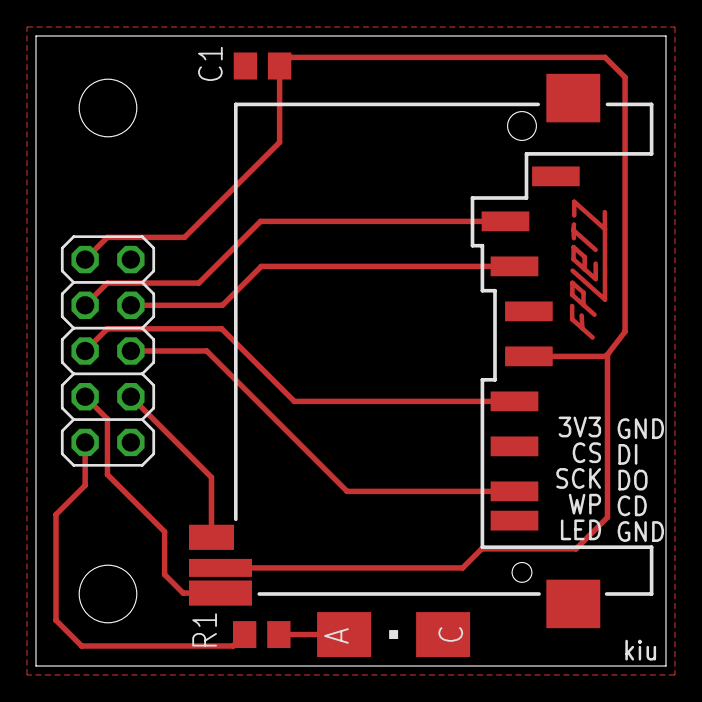
[picture p22: board rrsdc.brd from above]

Board: 4 copper layers, 35.0 x 35.0 mm, 5 parts (0 on the bottom side), 10 nets.
