kiu/RumbleRail/rrfdc/pcb/rrfdc.brd

## EAGLE design rrfdc/pcb/rrfdc.brd (2014-01-03)

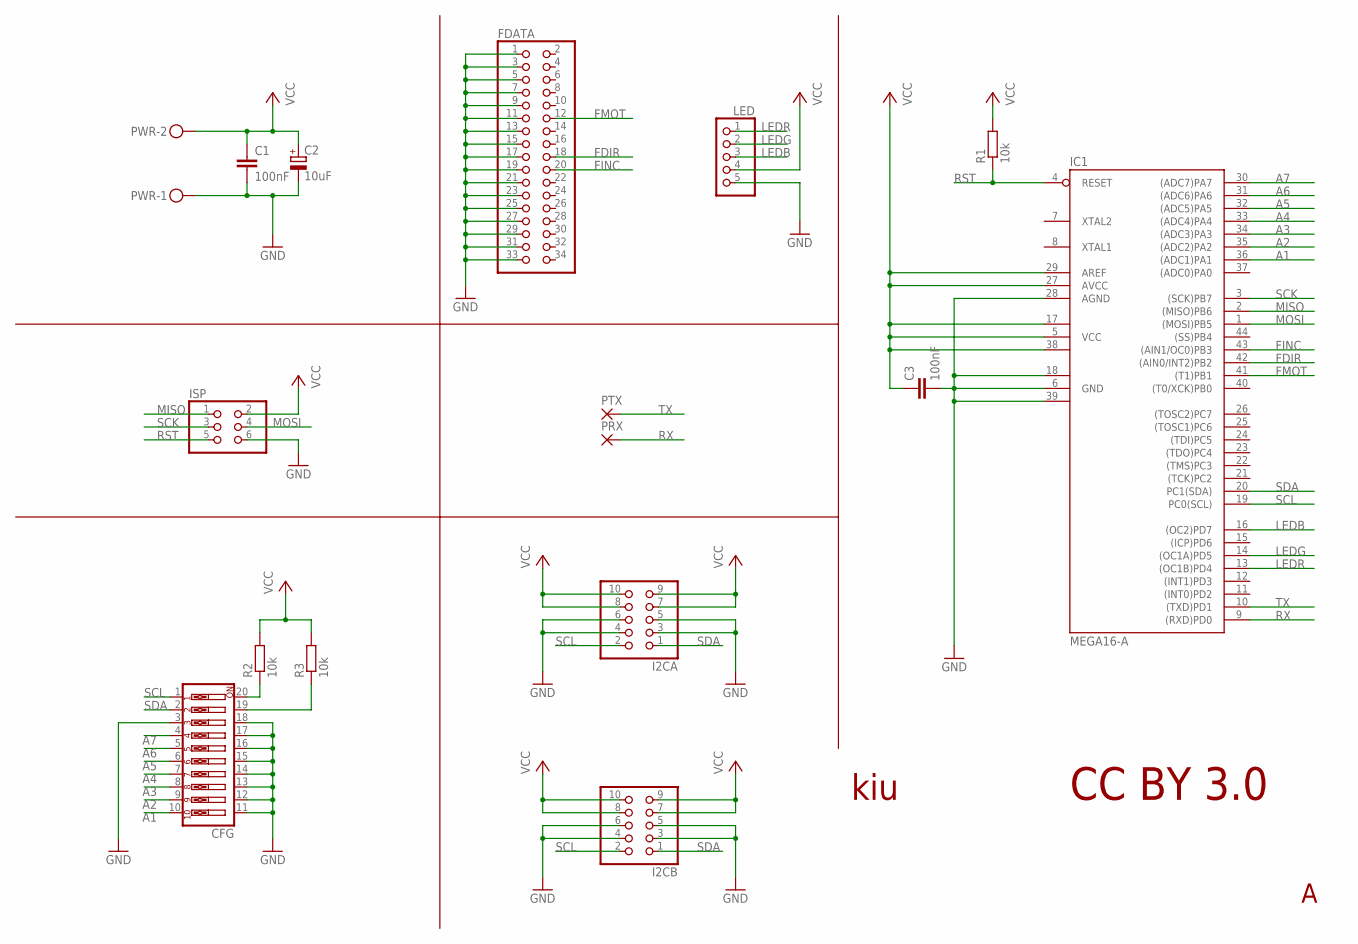
[picture p23: schematic rrfdc.sch]

Parts:
C1, C3: 100nF; C0805
C2: 10uF; CT3216
CFG: SW_DIP-10; EDG-10
FDATA: PINHD-2X17; 2X17
I2CA, I2CB: PINHD-2X5; 2X05
IC1: MEGA16-A; TQFP44
ISP: PINHD-2X3; 2X03
LED: PINHD-1X5; 1X05
PRX: SMD2; SMD1,27-2,54
PTX: SMD2; SMD1,27-2,54
PWR: MKDSN1,5/2-5,08
R1, R2, R3: 10k; R0805

Connections:
A1: CFG.10, IC1.36 ((ADC1)PA1)
A2: CFG.9, IC1.35 ((ADC2)PA2)
A3: CFG.8, IC1.34 ((ADC3)PA3)
A4: CFG.7, IC1.33 ((ADC4)PA4)
A5: CFG.6, IC1.32 ((ADC5)PA5)
A6: CFG.5, IC1.31 ((ADC6)PA6)
A7: CFG.4, IC1.30 ((ADC7)PA7)
FDIR: FDATA.18, IC1.42 ((AIN0/INT2)PB2)
FINC: FDATA.20, IC1.43 ((AIN1/OC0)PB3)
FMOT: FDATA.12, IC1.41 ((T1)PB1)
GND: C1.2, C2.-, C3.2, CFG.3, CFG.11, CFG.12, CFG.13, CFG.14, CFG.15, CFG.16, CFG.17, CFG.18, FDATA.1, FDATA.3, FDATA.5, FDATA.7, FDATA.9, FDATA.11, FDATA.13, FDATA.15, FDATA.17, FDATA.19, FDATA.21, FDATA.23, FDATA.25, FDATA.27, FDATA.29, FDATA.31, FDATA.33, I2CA.3, I2CA.4, I2CA.5, I2CA.6, I2CB.3, I2CB.4, I2CB.5, I2CB.6, IC1.6 (GND), IC1.18 (GND1), IC1.28 (AGND), IC1.39 (GND2), ISP.6, LED.5, PWR.1
LEDB: IC1.16 ((OC2)PD7), LED.3
LEDG: IC1.14 ((OC1A)PD5), LED.2
LEDR: IC1.13 ((OC1B)PD4), LED.1
MISO: IC1.2 ((MISO)PB6), ISP.1
MOSI: IC1.1 ((MOSI)PB5), ISP.4
unnamed: CFG.20, R2.1
unnamed: CFG.19, R3.1
RST: IC1.4 (RESET), ISP.5, R1.1
RX: IC1.9 ((RXD)PD0), PRX.1
SCK: IC1.3 ((SCK)PB7), ISP.3
SCL: CFG.1, I2CA.2, I2CB.2, IC1.19 (PC0(SCL))
SDA: CFG.2, I2CA.1, I2CB.1, IC1.20 (PC1(SDA))
TX: IC1.10 ((TXD)PD1), PTX.1
VCC: C1.1, C2.+, C3.1, I2CA.7, I2CA.8, I2CA.9, I2CA.10, I2CB.7, I2CB.8, I2CB.9, I2CB.10, IC1.5 (VCC), IC1.17 (VCC1), IC1.27 (AVCC), IC1.29 (AREF), IC1.38 (VCC2), ISP.2, LED.4, PWR.2, R1.2, R2.2, R3.2

Notes on the sheet:
CC BY 3.0
kiu

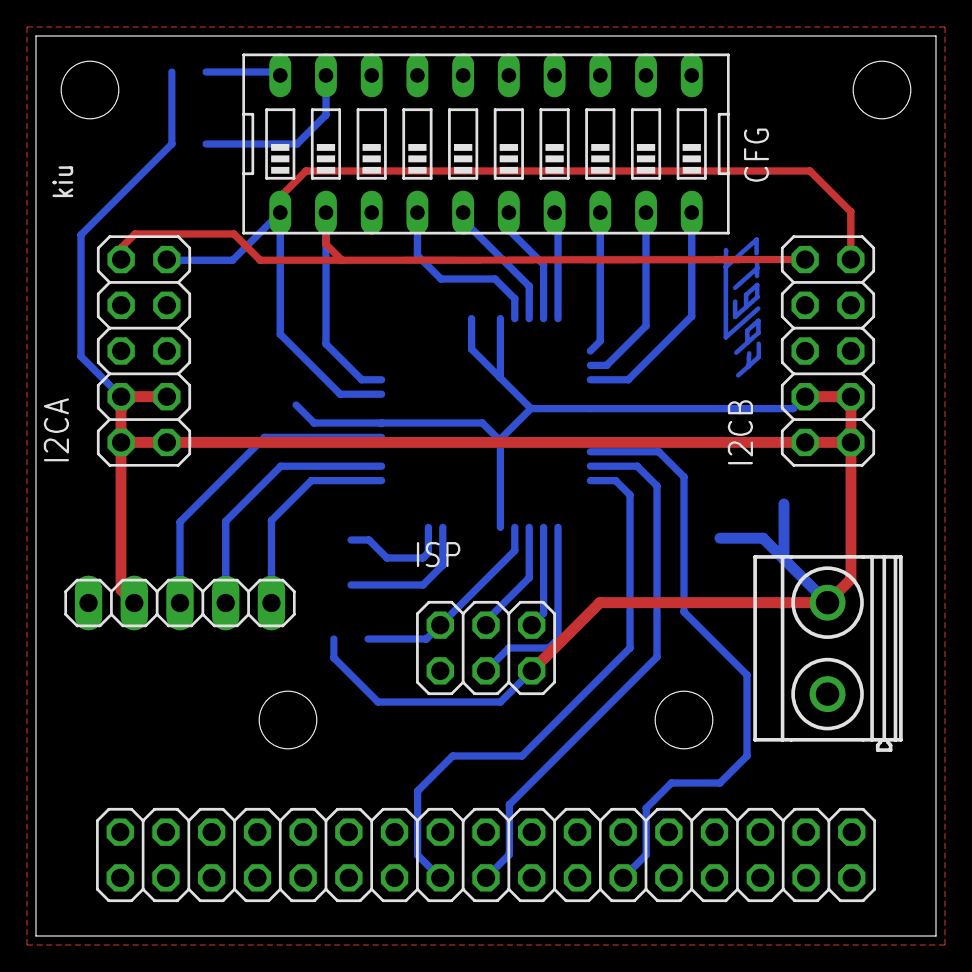
[picture p24: board rrfdc.brd from above]

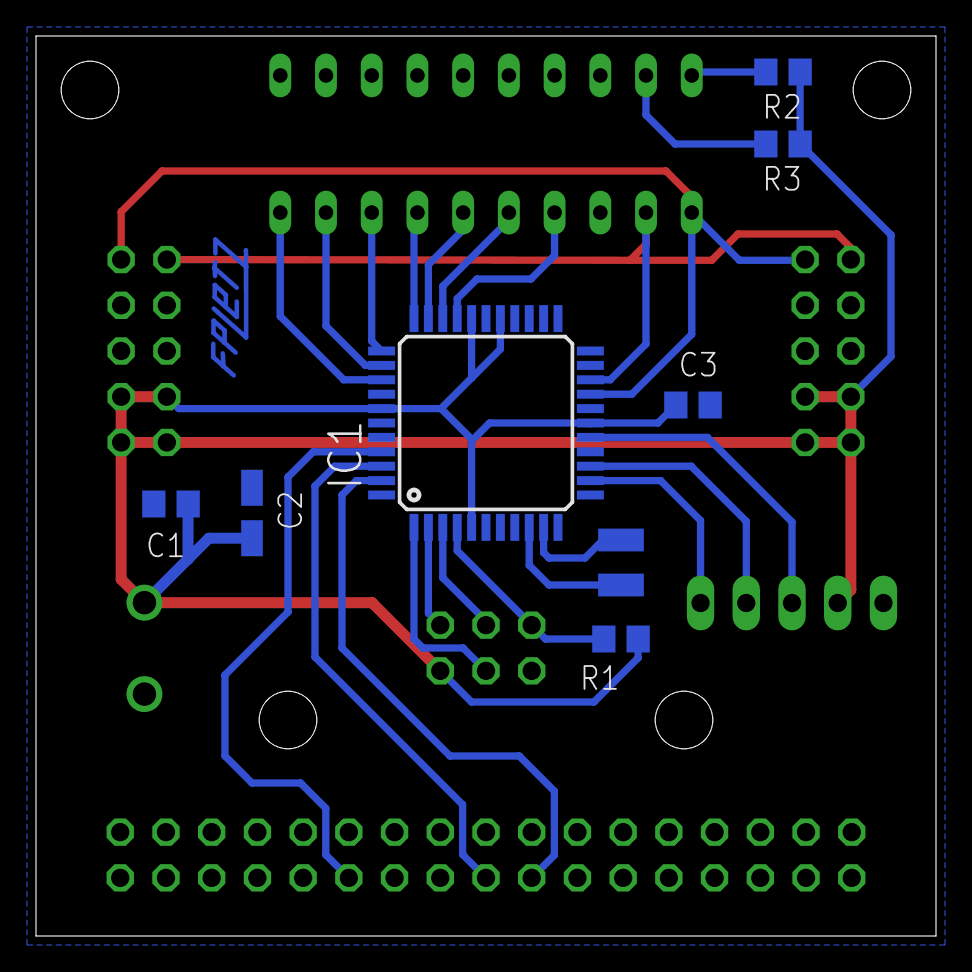
[picture p25: board rrfdc.brd from below]

Board: 4 copper layers, 50.0 x 50.0 mm, 16 parts (9 on the bottom side), 25 nets.
